skogaby/skogaslider/README.md

# skogaslider
Firmware, CAD, and PCB files for the skogaslider, an RP2040-based controller to simulate Chunithm's gameplay experience
