skogaby/skogaslider/KiCAD Projects/skogaslider-main-pcb/skogaslider-main-pcb.step

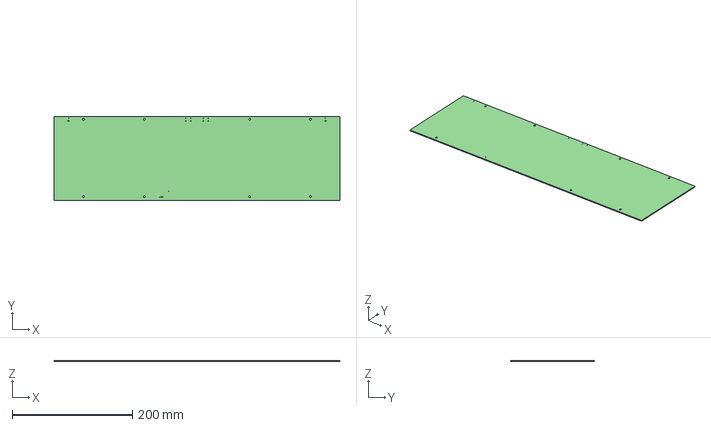
[picture p1: CAD file, 2022-11-13]
KiCAD Projects/skogaslider-main-pcb/skogaslider-main-pcb.step
475.0 x 140.3 x 1.60 mm
