skogaby/skogaslider/KiCAD Projects/skogaslider-main-pcb/skogaslider-main-pcb.kicad_pcb

## KiCad design KiCAD Projects/skogaslider-main-pcb/skogaslider-main-pcb.kicad_pcb (2022-11-17)

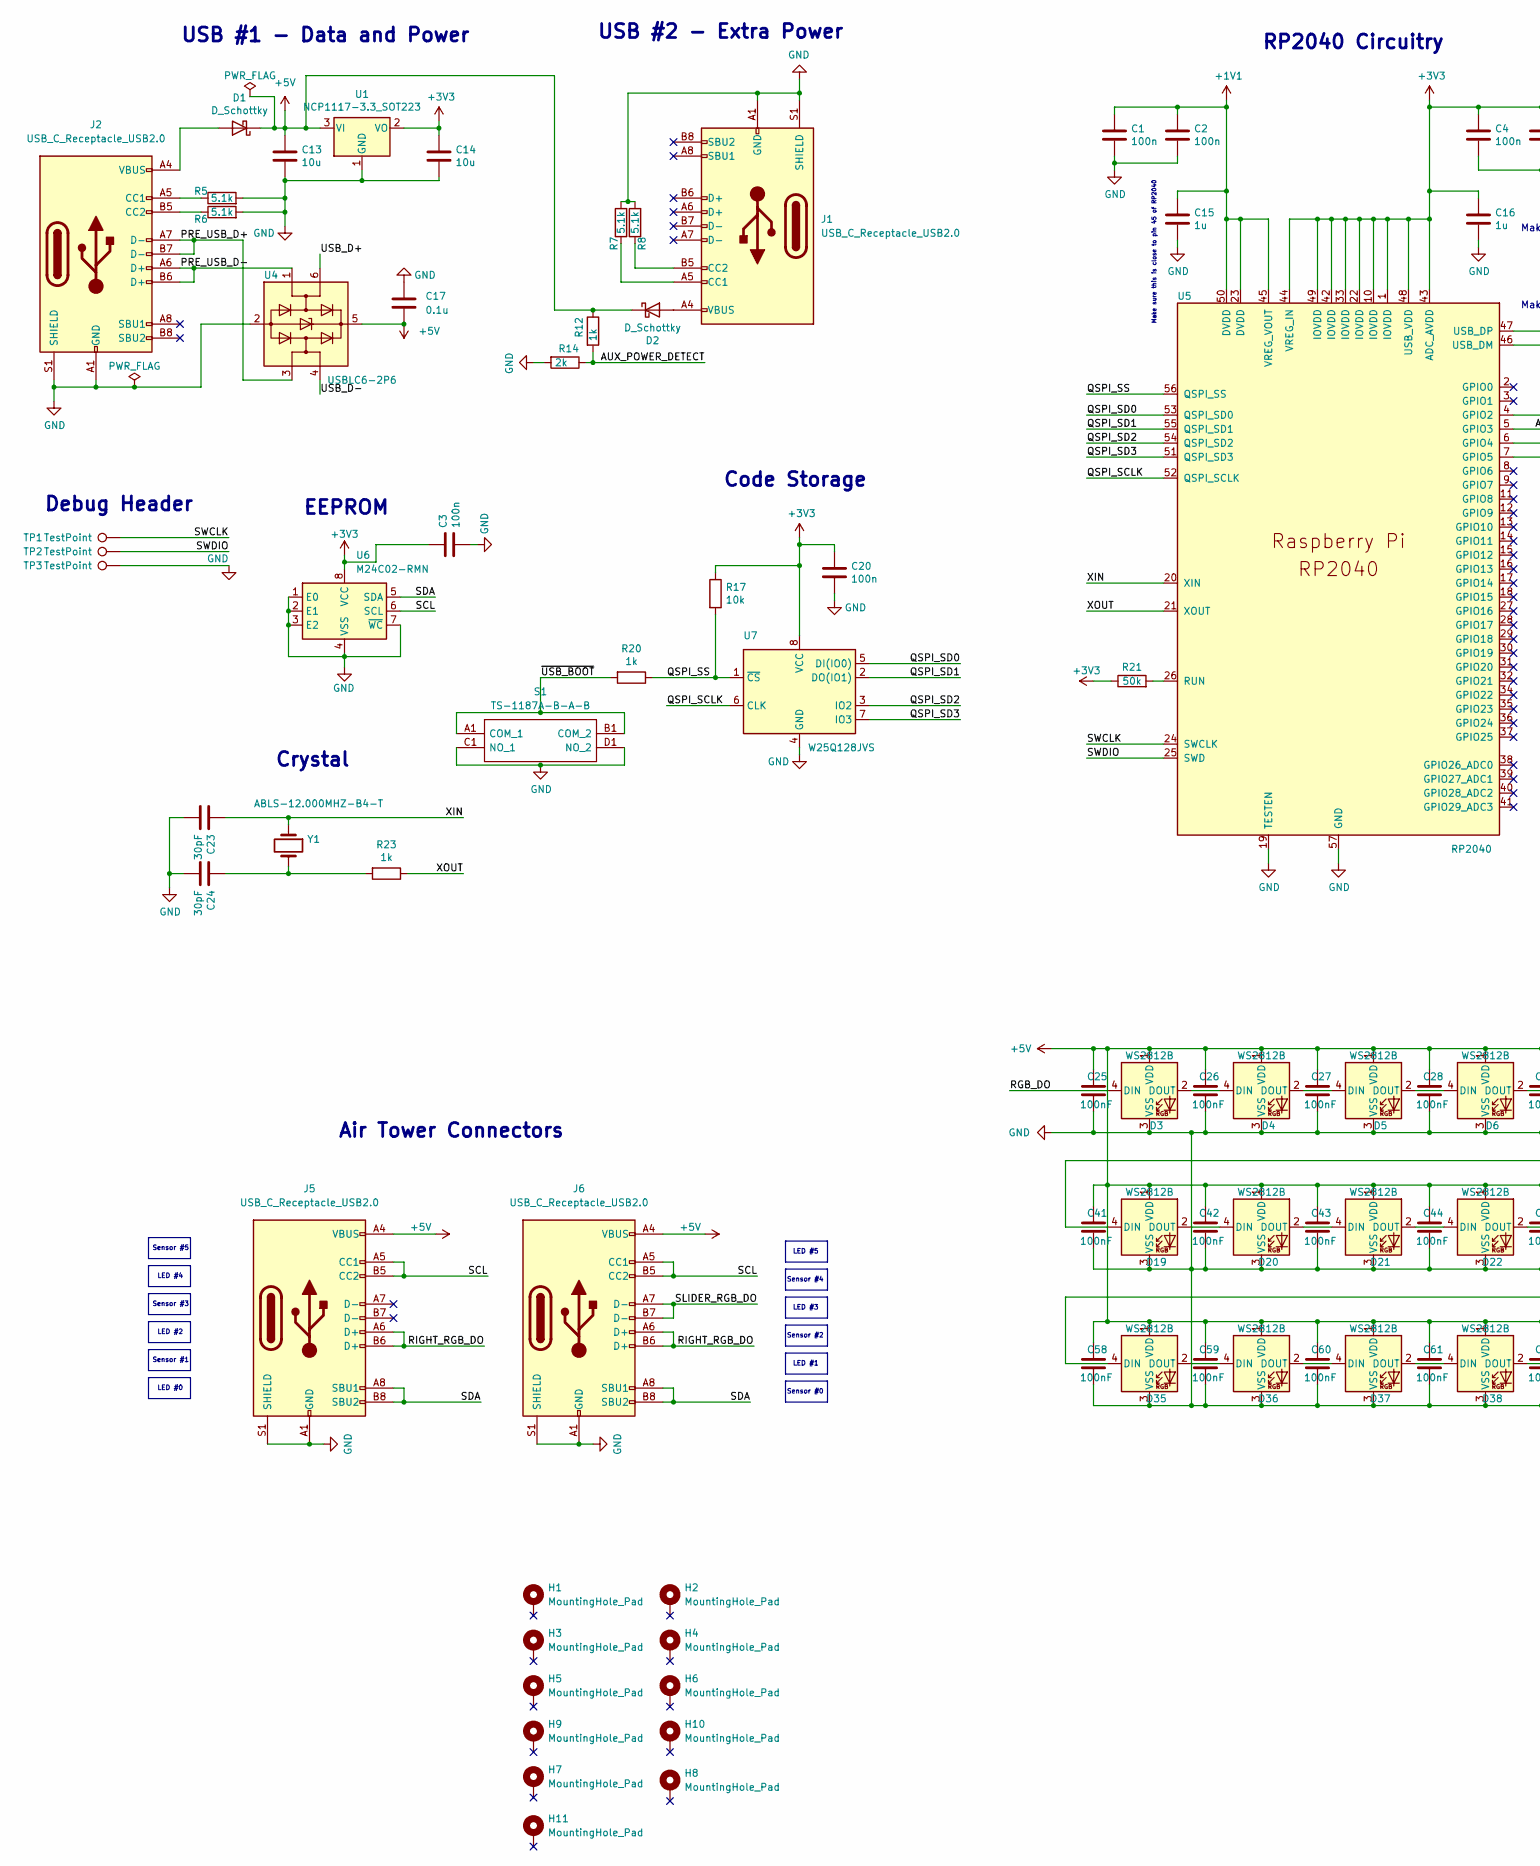
[picture p2: schematic skogaslider-main-pcb.kicad_sch, part in row 1, column 1]

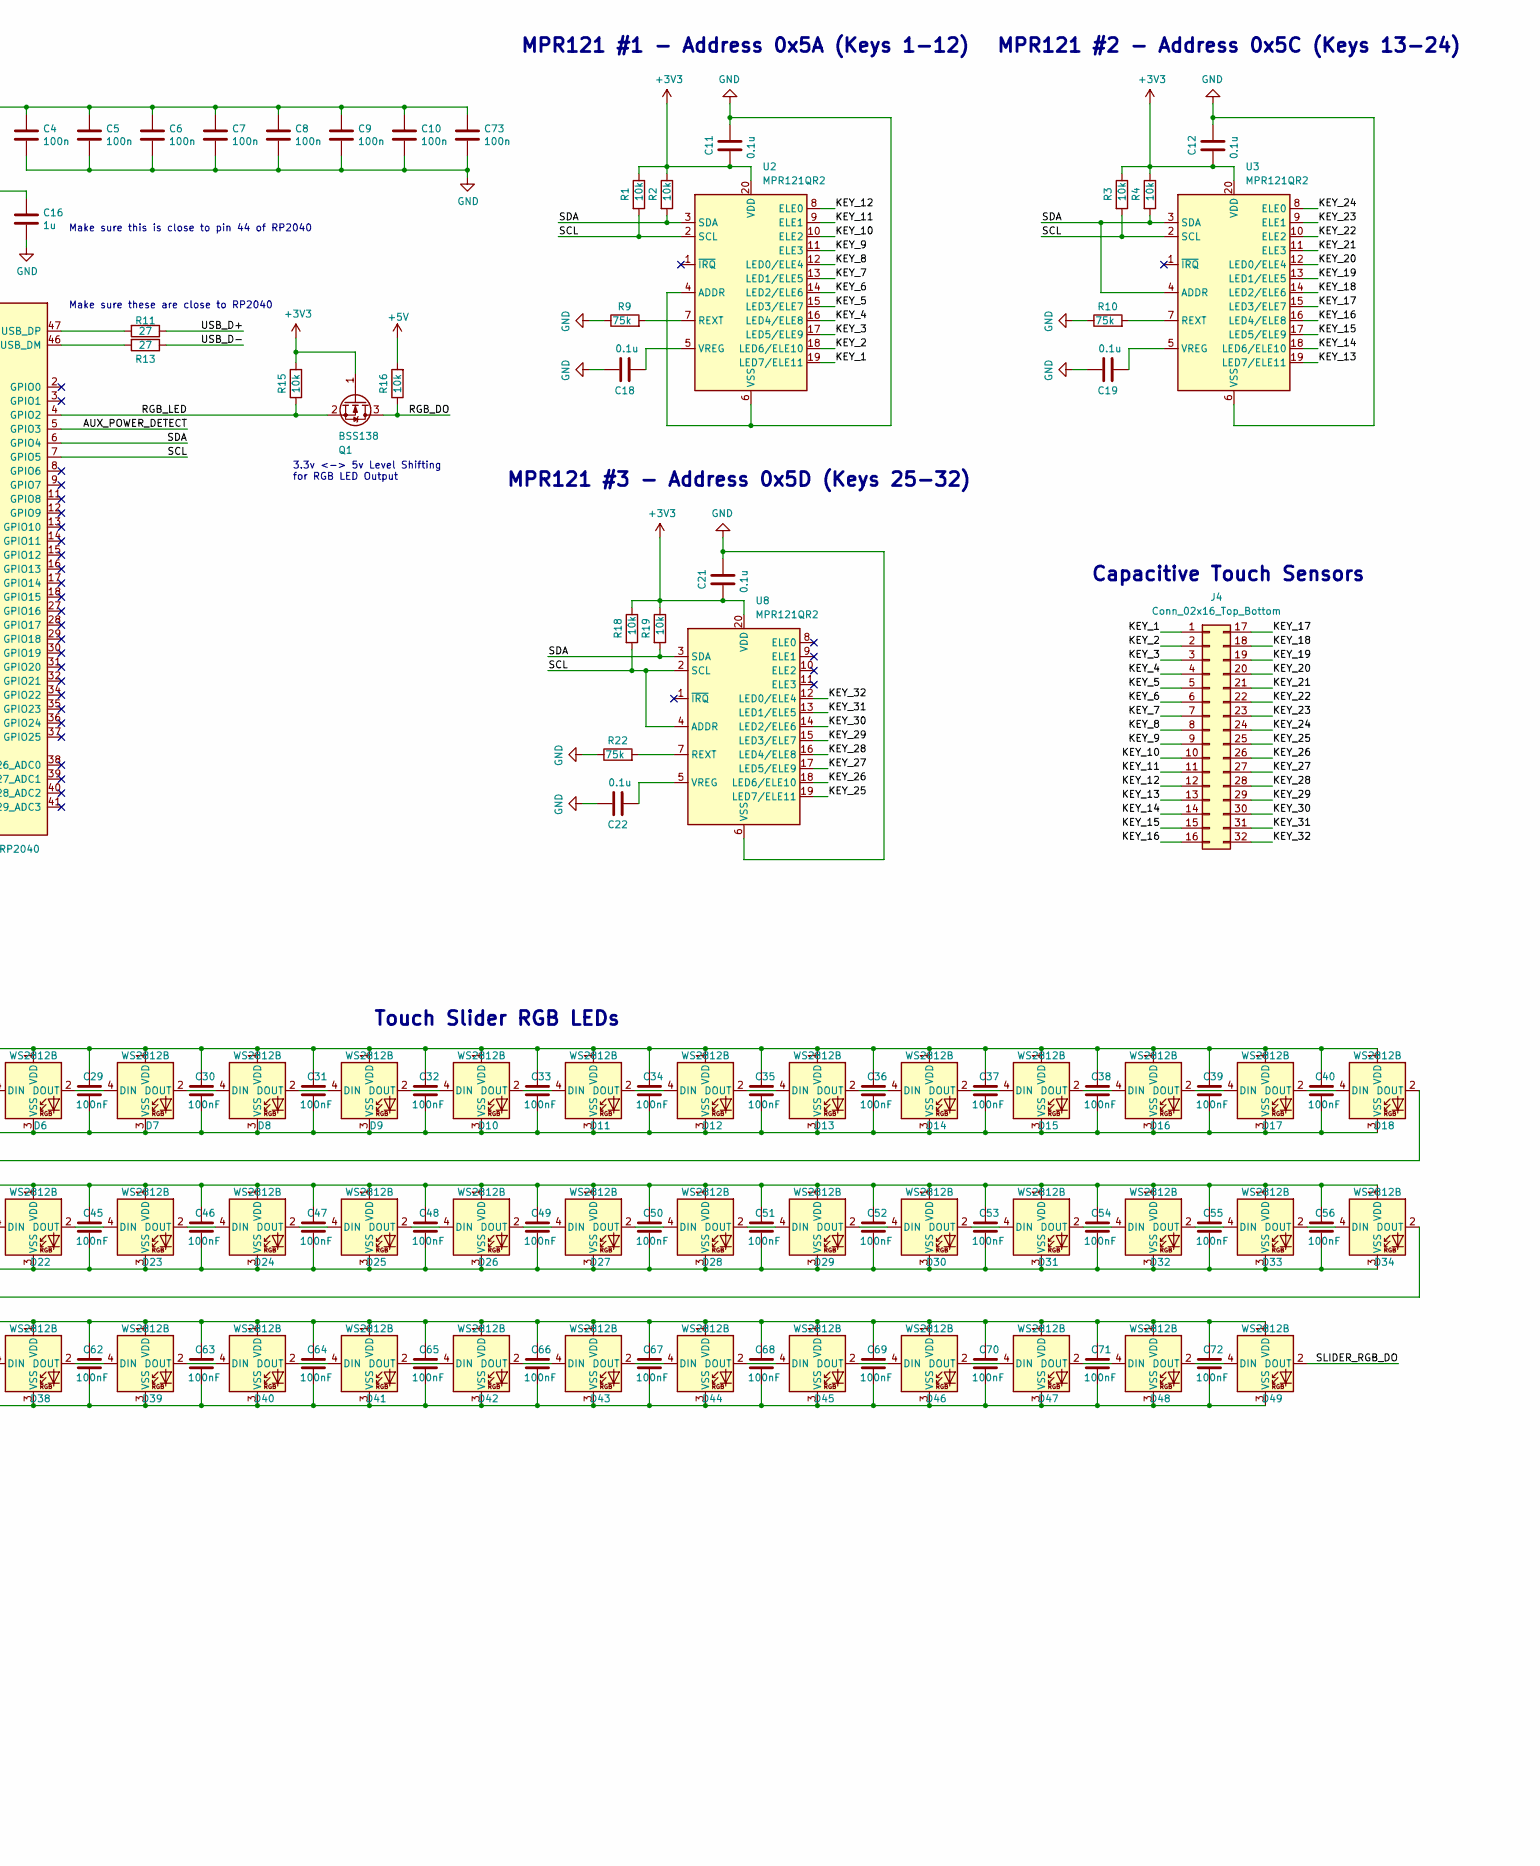
[picture p3: schematic skogaslider-main-pcb.kicad_sch, part in row 1, column 2]

Parts:
C1, C2, C3, C4, C5, C6, C7, C8, C9, C10, C20, C73: 100n; C_0402_1005Metric
C11, C12, C17, C18, C19, C21, C22: 0.1u; C_0402_1005Metric
C13, C14: 10u; C_0805_2012Metric
C15, C16: 1u; C_0402_1005Metric
C23, C24: 30pF; C_0402_1005Metric
C25, C26, C27, C28, C29, C30, C31, C32, C33, C34, C35, C36, C37, C38, C39, C40, C41, C42, C43, C44, C45, C46, C47, C48, C49, C50, C51, C52, C53, C54, C55, C56, C58, C59, C60, C61, C62, C63, C64, C65, C66, C67, C68, C69, C70, C71, C72: 100nF; C_0402_1005Metric
D1, D2: D_Schottky; D_SMA; LCSC C22452
D3, D4, D5, D6, D7, D8, D9, D10, D11, D12, D13, D14, D15, D16, D17, D18, D19, D20, D21, D22, D23, D24, D25, D26, D27, D28, D29, D30, D31, D32, D33, D34, D35, D36, D37, D38, D39, D40, D41, D42, D43, D44, D45, D46, D47, D48, D49: WS2812B; WS2812B-4020
H1, H2, H3, H4, H5, H6, H7, H8, H9, H10, H11: MountingHole_Pad; MountingHole_3.2mm_M3_DIN965_Pad_TopBottom
J1, J2, J5, J6: USB_C_Receptacle_USB2.0; USB_C_Receptacle_HRO_TYPE-C-31-M-12
J4: Conn_02x16_Top_Bottom; Pads
Q1: BSS138; SOT-23
R1, R2, R3, R4, R15, R16, R17, R18, R19: 10k; R_0603_1608Metric
R5, R6, R7, R8: 5.1k; R_0603_1608Metric
R9, R10, R22: 75k; R_0603_1608Metric
R11, R13: 27; R_0603_1608Metric
R12, R20: 1k; R_0603_1608Metric
R14: 2k; R_0603_1608Metric
R21: 50k; R_0603_1608Metric
R23: 1k; R_0402_1005Metric
S1: TS-1187A-B-A-B; TS1187ABAB; Manufacturer_Part_Number TS-1187A-B-A-B
TP1, TP2, TP3: TestPoint; TestPoint_Pad_1.0x1.0mm
U1: NCP1117-3.3_SOT223; SOT-223-3_TabPin2
U2, U3, U8: MPR121QR2; UQFN-20_3x3mm_P0.4mm
U4: USBLC6-2P6; SOT-666
U5: RP2040; RP2040-QFN-56
U6: M24C02-RMN; SOIC-8_3.9x4.9mm_P1.27mm
U7: W25Q128JVS; SOIC-8_5.23x5.23mm_P1.27mm
Y1: ABLS-12.000MHZ-B4-T; Crystal_SMD_HC49-US

Connections:
+1V1: C1.1, C2.1, C15.1, U5.23 (DVDD), U5.45 (VREG_VOUT), U5.50 (DVDD)
+3V3: C3.1, C4.1, C5.1, C6.1, C7.1, C8.1, C9.1, C10.1, C11.2, C12.2, C14.1, C16.1, C20.1, C21.2, C73.1, Q1.1 (G), R1.1, R2.1, R3.1, R4.1, R15.2, R17.1, R18.1, R19.1, R21.1, U1.2 (VO), U2.20 (VDD), U3.20 (VDD), U5.1 (IOVDD), U5.10 (IOVDD), U5.22 (IOVDD), U5.33 (IOVDD), U5.42 (IOVDD), U5.43 (ADC_AVDD), U5.44 (VREG_IN), U5.48 (USB_VDD), U5.49 (IOVDD), U6.8 (VCC), U7.8 (VCC), U8.20 (VDD)
+5V: C13.1, C17.2, C25.1, C26.1, C27.1, C28.1, C29.1, C30.1, C31.1, C32.1, C33.1, C34.1, C35.1, C36.1, C37.1, C38.1, C39.1, C40.1, C41.1, C42.1, C43.1, C44.1, C45.1, C46.1, C47.1, C48.1, C49.1, C50.1, C51.1, C52.1, C53.1, C54.1, C55.1, C56.1, C58.1, C59.1, C60.1, C61.1, C62.1, C63.1, C64.1, C65.1, C66.1, C67.1, C68.1, C69.1, C70.1, C71.1, C72.1, D1.1 (K), D2.1 (K), D3.1 (VDD), D4.1 (VDD), D5.1 (VDD), D6.1 (VDD), D7.1 (VDD), D8.1 (VDD), D9.1 (VDD), D10.1 (VDD), D11.1 (VDD), D12.1 (VDD), D13.1 (VDD), D14.1 (VDD), D15.1 (VDD), D16.1 (VDD), D17.1 (VDD), D18.1 (VDD), D19.1 (VDD), D20.1 (VDD), D21.1 (VDD), D22.1 (VDD), D23.1 (VDD), D24.1 (VDD), D25.1 (VDD), D26.1 (VDD), D27.1 (VDD), D28.1 (VDD), D29.1 (VDD), D30.1 (VDD), D31.1 (VDD), D32.1 (VDD), D33.1 (VDD), D34.1 (VDD), D35.1 (VDD), D36.1 (VDD), D37.1 (VDD), D38.1 (VDD), D39.1 (VDD), D40.1 (VDD), D41.1 (VDD), D42.1 (VDD), D43.1 (VDD), D44.1 (VDD), D45.1 (VDD), D46.1 (VDD), D47.1 (VDD), D48.1 (VDD), D49.1 (VDD), J5.A4 (VBUS), J5.A9 (VBUS), J5.B4 (VBUS), J5.B9 (VBUS), J6.A4 (VBUS), J6.A9 (VBUS), J6.B4 (VBUS), J6.B9 (VBUS), R12.1, R16.2, U1.3 (VI), U4.5 (VBUS)
/AUX_POWER_DETECT: R12.2, R14.1, U5.5 (GPIO3)
/KEY_1: J4.1, U2.19 (LED7/ELE11)
/KEY_2: J4.2, U2.18 (LED6/ELE10)
/KEY_3: J4.3, U2.17 (LED5/ELE9)
/KEY_4: J4.4, U2.16 (LED4/ELE8)
/KEY_5: J4.5, U2.15 (LED3/ELE7)
/KEY_6: J4.6, U2.14 (LED2/ELE6)
/KEY_7: J4.7, U2.13 (LED1/ELE5)
/KEY_8: J4.8, U2.12 (LED0/ELE4)
/KEY_9: J4.9, U2.11 (ELE3)
/KEY_10: J4.10, U2.10 (ELE2)
/KEY_11: J4.11, U2.9 (ELE1)
/KEY_12: J4.12, U2.8 (ELE0)
/KEY_13: J4.13, U3.19 (LED7/ELE11)
/KEY_14: J4.14, U3.18 (LED6/ELE10)
/KEY_15: J4.15, U3.17 (LED5/ELE9)
/KEY_16: J4.16, U3.16 (LED4/ELE8)
/KEY_17: J4.17, U3.15 (LED3/ELE7)
/KEY_18: J4.18, U3.14 (LED2/ELE6)
/KEY_19: J4.19, U3.13 (LED1/ELE5)
/KEY_20: J4.20, U3.12 (LED0/ELE4)
/KEY_21: J4.21, U3.11 (ELE3)
/KEY_22: J4.22, U3.10 (ELE2)
/KEY_23: J4.23, U3.9 (ELE1)
/KEY_24: J4.24, U3.8 (ELE0)
/KEY_25: J4.25, U8.19 (LED7/ELE11)
/KEY_26: J4.26, U8.18 (LED6/ELE10)
/KEY_27: J4.27, U8.17 (LED5/ELE9)
/KEY_28: J4.28, U8.16 (LED4/ELE8)
/KEY_29: J4.29, U8.15 (LED3/ELE7)
/KEY_30: J4.30, U8.14 (LED2/ELE6)
/KEY_31: J4.31, U8.13 (LED1/ELE5)
/KEY_32: J4.32, U8.12 (LED0/ELE4)
/PRE_USB_D+: J2.A7 (D-), J2.B7 (D-), U4.3 (I/O2)
/PRE_USB_D-: J2.A6 (D+), J2.B6 (D+), U4.1 (I/O1)
/QSPI_SCLK: U5.52 (QSPI_SCLK), U7.6 (CLK)
/QSPI_SD0: U5.53 (QSPI_SD0), U7.5 (DI(IO0))
/QSPI_SD1: U5.55 (QSPI_SD1), U7.2 (DO(IO1))
/QSPI_SD2: U5.54 (QSPI_SD2), U7.3 (IO2)
/QSPI_SD3: U5.51 (QSPI_SD3), U7.7 (IO3)
/QSPI_SS: R17.2, R20.1, U5.56 (QSPI_SS), U7.1 (~CS)
/RGB_DO: D3.4 (DIN), Q1.3 (D), R16.1
/RGB_LED: Q1.2 (S), R15.1, U5.4 (GPIO2)
/RIGHT_RGB_DO: J5.A6 (D+), J5.B6 (D+), J6.A6 (D+), J6.B6 (D+)
/SCL: J5.A5 (CC1), J5.B5 (CC2), J6.A5 (CC1), J6.B5 (CC2), R1.2, R3.2, R18.2, U2.2 (SCL), U3.2 (SCL), U5.7 (GPIO5), U6.6 (SCL), U8.2 (SCL), U8.4 (ADDR)
/SDA: J5.A8 (SBU1), J5.B8 (SBU2), J6.A8 (SBU1), J6.B8 (SBU2), R2.2, R4.2, R19.2, U2.3 (SDA), U3.3 (SDA), U3.4 (ADDR), U5.6 (GPIO4), U6.5 (SDA), U8.3 (SDA)
/SLIDER_RGB_DO: D49.2 (DOUT), J6.A7 (D-), J6.B7 (D-)
/SWCLK: TP1.1, U5.24 (SWCLK)
/SWDIO: TP2.1, U5.25 (SWD)
/USB_D+: R11.1, U4.6 (I/O1)
/USB_D-: R13.1, U4.4 (I/O2)
/XIN: C23.1, U5.20 (XIN), Y1.1
/XOUT: R23.1, U5.21 (XOUT)
/~USB_BOOT: R20.2, S1.A1 (COM_1), S1.B1 (COM_2)
GND: C1.2, C2.2, C3.2, C4.2, C5.2, C6.2, C7.2, C8.2, C9.2, C10.2, C11.1, C12.1, C13.2, C14.2, C15.2, C16.2, C17.1, C18.1, C19.1, C20.2, C21.1, C22.1, C23.2, C24.2, C25.2, C26.2, C27.2, C28.2, C29.2, C30.2, C31.2, C32.2, C33.2, C34.2, C35.2, C36.2, C37.2, C38.2, C39.2, C40.2, C41.2, C42.2, C43.2, C44.2, C45.2, C46.2, C47.2, C48.2, C49.2, C50.2, C51.2, C52.2, C53.2, C54.2, C55.2, C56.2, C58.2, C59.2, C60.2, C61.2, C62.2, C63.2, C64.2, C65.2, C66.2, C67.2, C68.2, C69.2, C70.2, C71.2, C72.2, C73.2, D3.3 (VSS), D4.3 (VSS), D5.3 (VSS), D6.3 (VSS), D7.3 (VSS), D8.3 (VSS), D9.3 (VSS), D10.3 (VSS), D11.3 (VSS), D12.3 (VSS), D13.3 (VSS), D14.3 (VSS), D15.3 (VSS), D16.3 (VSS), D17.3 (VSS), D18.3 (VSS), D19.3 (VSS), D20.3 (VSS), D21.3 (VSS), D22.3 (VSS), D23.3 (VSS), D24.3 (VSS), D25.3 (VSS), D26.3 (VSS), D27.3 (VSS), D28.3 (VSS), D29.3 (VSS), D30.3 (VSS), D31.3 (VSS), D32.3 (VSS), D33.3 (VSS), D34.3 (VSS), D35.3 (VSS), D36.3 (VSS), D37.3 (VSS), D38.3 (VSS), D39.3 (VSS), D40.3 (VSS), D41.3 (VSS), D42.3 (VSS), D43.3 (VSS), D44.3 (VSS), D45.3 (VSS), D46.3 (VSS), D47.3 (VSS), D48.3 (VSS), D49.3 (VSS), J1.A1 (GND), J1.A12 (GND), J1.B1 (GND), J1.B12 (GND), J1.S1 (SHIELD), J2.A1 (GND), J2.A12 (GND), J2.B1 (GND), J2.B12 (GND), J2.S1 (SHIELD), J5.A1 (GND), J5.A12 (GND), J5.B1 (GND), J5.B12 (GND), J5.S1 (SHIELD), J6.A1 (GND), J6.A12 (GND), J6.B1 (GND), J6.B12 (GND), J6.S1 (SHIELD), R5.2, R6.2, R7.2, R8.2, R9.1, R10.1, R14.2, R22.1, S1.C1 (NO_1), S1.D1 (NO_2), TP3.1, U1.1 (GND), U2.4 (ADDR), U2.6 (VSS), U3.6 (VSS), U4.2 (GND), U5.19 (TESTEN), U5.57 (GND), U6.1 (E0), U6.2 (E1), U6.3 (E2), U6.4 (VSS), U6.7 (~WC), U7.4 (GND), U8.6 (VSS)
unnamed: C18.2, U2.5 (VREG)
unnamed: C19.2, U3.5 (VREG)
unnamed: C22.2, U8.5 (VREG)
unnamed: C24.1, R23.2, Y1.2
unnamed: D1.2 (A), J2.A4 (VBUS), J2.A9 (VBUS), J2.B4 (VBUS), J2.B9 (VBUS)
unnamed: D2.2 (A), J1.A4 (VBUS), J1.A9 (VBUS), J1.B4 (VBUS), J1.B9 (VBUS)
unnamed: D3.2 (DOUT), D4.4 (DIN)
unnamed: D4.2 (DOUT), D5.4 (DIN)
unnamed: D5.2 (DOUT), D6.4 (DIN)
unnamed: D6.2 (DOUT), D7.4 (DIN)
unnamed: D7.2 (DOUT), D8.4 (DIN)
unnamed: D8.2 (DOUT), D9.4 (DIN)
unnamed: D10.2 (DOUT), D11.4 (DIN)
unnamed: D9.2 (DOUT), D10.4 (DIN)
unnamed: D11.2 (DOUT), D12.4 (DIN)
unnamed: D12.2 (DOUT), D13.4 (DIN)
unnamed: D13.2 (DOUT), D14.4 (DIN)
unnamed: D14.2 (DOUT), D15.4 (DIN)
unnamed: D15.2 (DOUT), D16.4 (DIN)
unnamed: D16.2 (DOUT), D17.4 (DIN)
unnamed: D17.2 (DOUT), D18.4 (DIN)
unnamed: D18.2 (DOUT), D19.4 (DIN)
unnamed: D19.2 (DOUT), D20.4 (DIN)
unnamed: D20.2 (DOUT), D21.4 (DIN)
unnamed: D21.2 (DOUT), D22.4 (DIN)
unnamed: D22.2 (DOUT), D23.4 (DIN)
unnamed: D23.2 (DOUT), D24.4 (DIN)
unnamed: D24.2 (DOUT), D25.4 (DIN)
unnamed: D25.2 (DOUT), D26.4 (DIN)
unnamed: D26.2 (DOUT), D27.4 (DIN)
unnamed: D27.2 (DOUT), D28.4 (DIN)
unnamed: D28.2 (DOUT), D29.4 (DIN)
unnamed: D29.2 (DOUT), D30.4 (DIN)
unnamed: D30.2 (DOUT), D31.4 (DIN)
unnamed: D31.2 (DOUT), D32.4 (DIN)
unnamed: D32.2 (DOUT), D33.4 (DIN)
unnamed: D33.2 (DOUT), D34.4 (DIN)
unnamed: D34.2 (DOUT), D35.4 (DIN)
unnamed: D35.2 (DOUT), D36.4 (DIN)
unnamed: D36.2 (DOUT), D37.4 (DIN)
unnamed: D37.2 (DOUT), D38.4 (DIN)
unnamed: D38.2 (DOUT), D39.4 (DIN)
unnamed: D39.2 (DOUT), D40.4 (DIN)
unnamed: D40.2 (DOUT), D41.4 (DIN)
unnamed: D41.2 (DOUT), D42.4 (DIN)
unnamed: D42.2 (DOUT), D43.4 (DIN)
unnamed: D43.2 (DOUT), D44.4 (DIN)
unnamed: D44.2 (DOUT), D45.4 (DIN)
unnamed: D45.2 (DOUT), D46.4 (DIN)
unnamed: D46.2 (DOUT), D47.4 (DIN)
unnamed: D47.2 (DOUT), D48.4 (DIN)
unnamed: D48.2 (DOUT), D49.4 (DIN)
unnamed: J1.A5 (CC1), R7.1
unnamed: J1.B5 (CC2), R8.1
unnamed: J2.A5 (CC1), R5.1
unnamed: J2.B5 (CC2), R6.1
unnamed: R9.2, U2.7 (REXT)
unnamed: R10.2, U3.7 (REXT)
unnamed: R11.2, U5.47 (USB_DP)
unnamed: R13.2, U5.46 (USB_DM)
unnamed: R21.2, U5.26 (RUN)
unnamed: R22.2, U8.7 (REXT)

Notes on the sheet:
USB #2 - Extra Power
LED #4
Sensor #3
RP2040 Circuitry
Touch Slider RGB LEDs
LED #2
Make sure this is close to pin 45 of RP2040
Code Storage
Sensor #0
Sensor #1
Capacitive Touch Sensors
Crystal
USB #1 - Data and Power
Sensor #5
LED #5
MPR121 #1 - Address 0x5A (Keys 1-12)
LED #1
LED #3
MPR121 #2 - Address 0x5C (Keys 13-24)
LED #0
Debug Header
Air Tower Connectors
Sensor #4
Make sure this is close to pin 44 of RP2040
Sensor #2
3.3v <-> 5v Level Shifting for RGB LED Output
Make sure these are close to RP2040
MPR121 #3 - Address 0x5D (Keys 25-32)
EEPROM

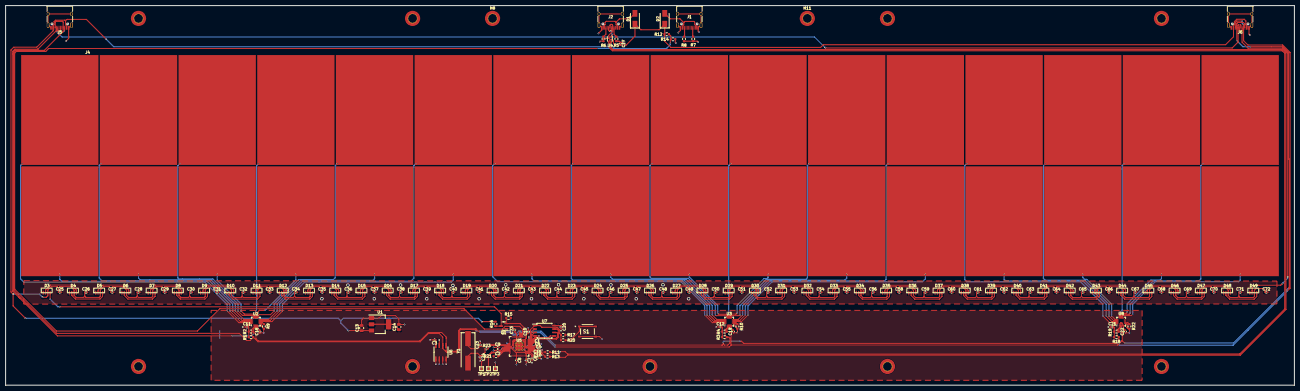
[picture p4: board skogaslider-main-pcb.kicad_pcb from above]

Board: 2 copper layers, 475.0 x 139.9 mm, 174 parts (0 on the bottom side), 120 nets.
