skogaby/skogaslider/(commit log)

2022-06-06 Initial commit, adding the preliminary schematic for the main slider PCB. Still need to do the air tower schematics, plus the PCB layouts, etc.
    [skogaslider-main-pcb.kicad_pcb, skogaslider-main-pcb.kicad_sch]
2022-06-06 Almost final schematic for the main slider, minus a couple of small tweaks. Significant progress on slider board layout. MPR121 layouts are essentially complete minus the key wiring. USB C ports and 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
    [skogaslider-main-pcb.kicad_pcb, skogaslider-main-pcb.kicad_sch]
2022-06-07 More layout progress for the main slider PCB
    [skogaslider-main-pcb.kicad_pcb, skogaslider-main-pcb.kicad_sch]
2022-06-14 PCB layout is almost complete for the mainboard, minus the board cuts, mounting holes, and power/ground planes
    [skogaslider-main-pcb.kicad_pcb, skogaslider-main-pcb.kicad_sch]
2022-06-14 First pass of the mainboard layout is done, besides art and mounting holes
    [skogaslider-main-pcb.kicad_pcb]
2022-06-15 Added JLCPCB part number mappings for everything, so we can export this via the jlcpcb plugin to order, once everything is finalized.
    [skogaslider-main-pcb-CuBottom.gbr, skogaslider-main-pcb-CuTop.gbr, skogaslider-main-pcb-EdgeCuts.gbr, skogaslider-main-pcb-MaskBottom.gbr, skogaslider-main-pcb-MaskTop.gbr, skogaslider-main-pcb-NPTH.drl, skogaslider-main-pcb-PTH.drl, skogaslider-main-pcb-PasteBottom.gbr]
2022-06-23 v0.1 of the slider PCB is likely complete, waiting for a prototype order to arrive before making any real changes.
    [skogaslider-main-pcb-CuBottom.gbr, skogaslider-main-pcb-CuTop.gbr, skogaslider-main-pcb-EdgeCuts.gbr, skogaslider-main-pcb-MaskBottom.gbr, skogaslider-main-pcb-MaskTop.gbr, skogaslider-main-pcb-NPTH.drl, skogaslider-main-pcb-PTH.drl, skogaslider-main-pcb-PasteBottom.gbr]
2022-07-04 Have the primary core keep track of whether the state has changed, rather than keep track of it within the TouchSlider class, since the scans for TouchSlider aren't coupled to when the states are act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
2022-07-09 Add a CDC interface to the tinyUSB config so we can get serial output alongside USB HID output. Requires pico-sdk 1.4.0+ to work correctly.
    [main.cpp, tusb_config.h]
2022-07-12 Implement a proper UsbOutput class for handling keyboard output. Limit the rate of LED strip updates to 250Hz (1/4 of the keyboard output rate)
2022-07-15 First pass implementation of the SEGA slider protocol for Chunithm/Project Diva. Still need to wire up serial and pass the data back and forth, but the protocol logic is in place.
2022-07-15 Attempting to fix the slider AC protocol communications, still fixing some bugs with serial processing
    [tusb_config.h]
2022-07-15 Attempting to fix serial communications by transmitting and reading one byte at a time, still working out some bugs though
    [main.cpp]
2022-07-16 The SEGA slider protocol is finally working correctly, but it seems to get slower over time, might need to change how serial is read
    [Mpr121.cpp, Mpr121.h, main.cpp, tusb_config.h]
2022-07-16 Small fixes for logging, and reading LED brightnesses correctly.
    [main.cpp]
2022-07-19 Separate out serial reading logic into its own separate class which can handle multiple different kinds of packets. Begin to stub out the implementation for emulating the 15093-06 LED boards, for air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
2022-07-19 Implement the first pass logic for reading LED packets, still need to implement the protocol processing itself.
2022-07-19 Stub out the protocol handlers for the LED boards, still need to fill out the responses
2022-07-19 Add 2 more CDC endpoints for LED 15093-06 emulation (1 endpoint for each board). This brings us to 4 CDC endpoints (stdio, slider, 2x LED)
2022-07-21 First pass implementation of the 15093-06 LED board protocol emulation. This is still untested for now.
2022-07-21 Keep track of how often we're updating air tower lights
2022-07-22 Small fix for the Pico SDK path resolution
2022-07-23 Fix LED board emulation. Now slider + dual LED board emulation works perfectly at the same time
    [main.cpp]
2022-07-23 Cut down on the number of static packet structures in the SegaSlider class to just a single response struct.
2022-07-23 Add a utility protocol command for the LED board emulation to get which side the board is for. This will be used for a utility desktop application to determine which COM port is which emulated device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
2022-07-31 Fix a bug in the slider LED report handling, and add handlers for slider commands 0x09 and 0x0A
2022-11-13 New revision of the mainboard schematic and layout. Switched the air towers from HDMI to USB-C, and made them use the I2C bus for communication to reduce the number of pins
    [skogaslider-main-pcb-CuBottom.gbr, skogaslider-main-pcb-CuTop.gbr, skogaslider-main-pcb-EdgeCuts.gbr, skogaslider-main-pcb-MaskBottom.gbr, skogaslider-main-pcb-MaskTop.gbr, skogaslider-main-pcb-NPTH.drl, skogaslider-main-pcb-PTH.drl, skogaslider-main-pcb-PasteBottom.gbr]
2022-11-14 Fix up the top edge of the board so it fits within the controller CAD, and add more mounting holes.
    [skogaslider-main-pcb.kicad_pcb, skogaslider-main-pcb.kicad_sch]
2022-11-17 Minor revision of the slider PCB to re-arrange the mounting holes to fit the CAD better.
    [skogaslider-main-pcb.kicad_pcb, skogaslider-main-pcb.kicad_sch]
